brysonmedd/Deskinator/docs/images/code-flow.png

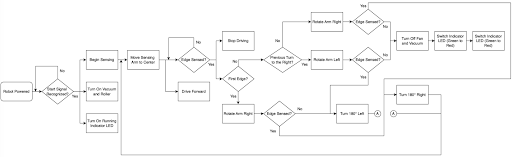
docs/images/code-flow.png
