brysonmedd/Deskinator/(commit log)

2026-10-23 Reorganize repo and rewrite README
    Move sketch to firmware/, report to docs/, and rename images under
    docs/images/. Add README with overview, pin map, build steps, results,
    and known limitations. No code changes.
    Claude-Session: https://claude.ai/code/session_016M7DYiWP74RxGQm6KChhKb
2026-10-23 Replace code flow image with Mermaid chart in README
2026-10-23 Fix Stop driving branch in README flow chart
